NatiJoseph/ImageDisplayingSword/Results/Photos/WhatsApp Image 2021-04-10 at 18.08.34 (1).jpeg

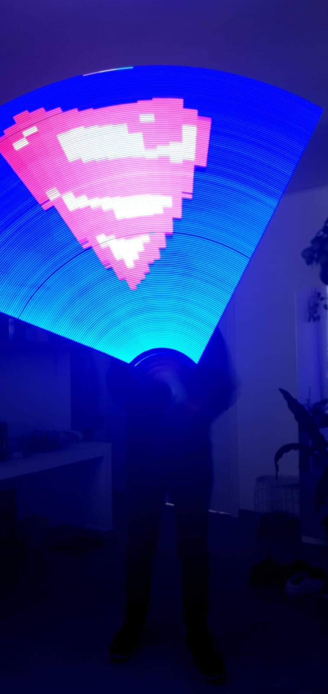
Results/Photos/WhatsApp Image 2021-04-10 at 18.08.34 (1).jpeg
