NatiJoseph/ImageDisplayingSword/CRML_Poster_ImageDisplaying_proj.pptx

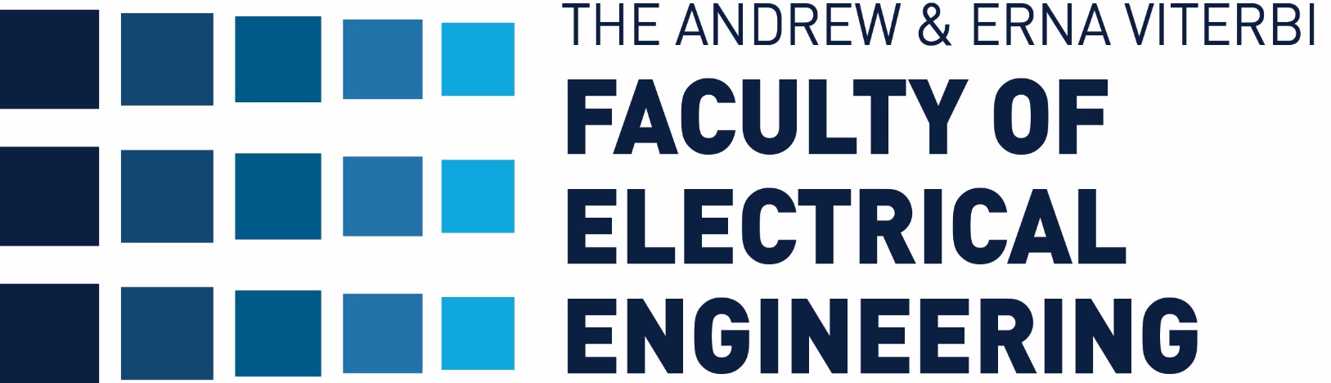
[picture p3: figure]
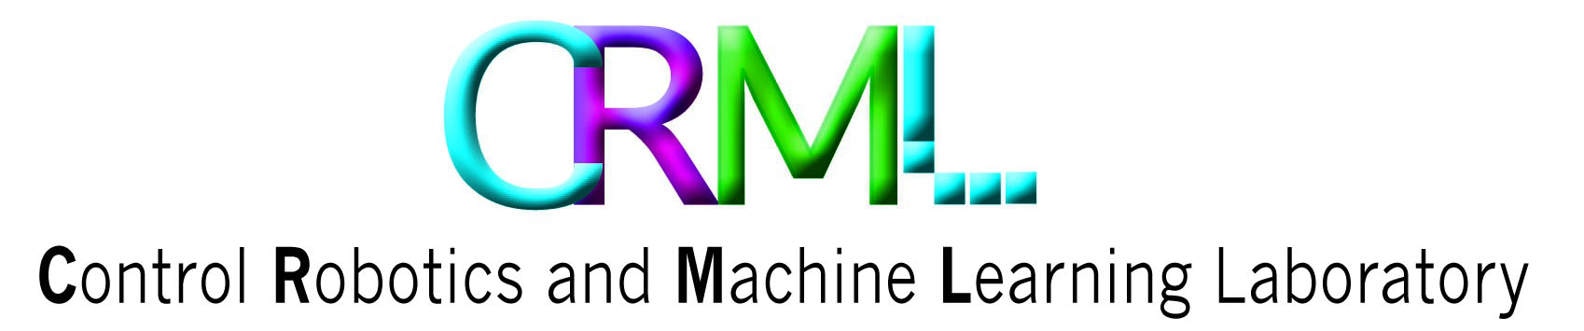
[picture p4: figure]
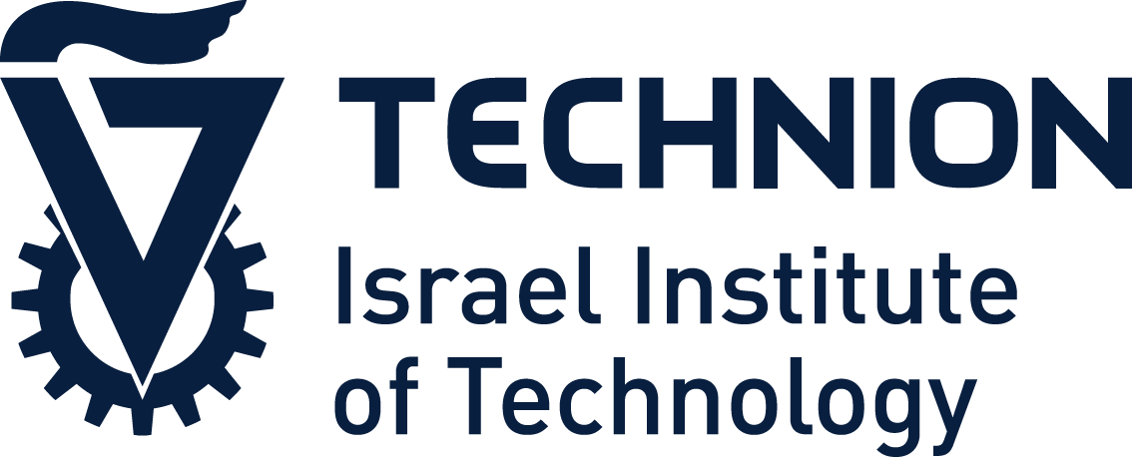
[picture p5: figure]

Image
Displaying
Sword

Nathaniel Joseph and Daniel Gutman, Supervised by Koby Kohai

Introduction

- Persistence of Vision (POV) refers to the optical illusion that occurs when visual perception of an object does not cease for some time after the rays of light proceeding from it have ceased to enter the eye.
- The entire film industry is based on POV – this is how a few pictures of a house displayed one after each other can produce a film of a running horse.

Goals

- Produce a picture from a single line of LED’s by moving it swiftly.
  - Gyroscope and Accelerometer provides input
  - Computing device angle and pixels to display.
  - Fast LED display.

Challenges

- No prior experience in IoT.
- Coronavirus pandemic.
- No suitable solutions in the literature

Software

- Fast execution and easy to operate.
- Reading values calculated by the MPU6050 gyroscope and accelerometer in order to estimate the location and angle of the device in 3-axis.
- Converting sensor output to radians using the formula rad=angle∗π/180 .
- Calculating the proper pixels to display from the picture matrix via (pixel_x , pixel_y )=(r∗cos(angle_(rad) )+ 3∗NUMPIXELS, r∗sin(angle_(rad) ))
- Displaying the corresponding RGB pixels for each LED.

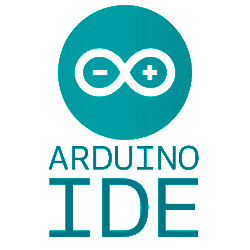
[picture p6: figure]
botsolvers.com/wp-content/uploads/2020/04/Ardui...

Hardware

- Low cost.
- Low power .
- Small footprints.
- High quality.
- Single ESP32 D1 mini controller used to control:
  - MPU6050 sensor for gyroscope and accelerometer data.
  - WS2182B LED strip in order to produce the image.
  - Audio Amplifier for sound.
- Custom design with SolidWorks of exterior shell for the device:
  - Special design for ventilation of battery and DC-DC convertor.
  - Easy connection to ESP32 controller.
  - Audio holes for better sound quality.
  - Easy assembling.

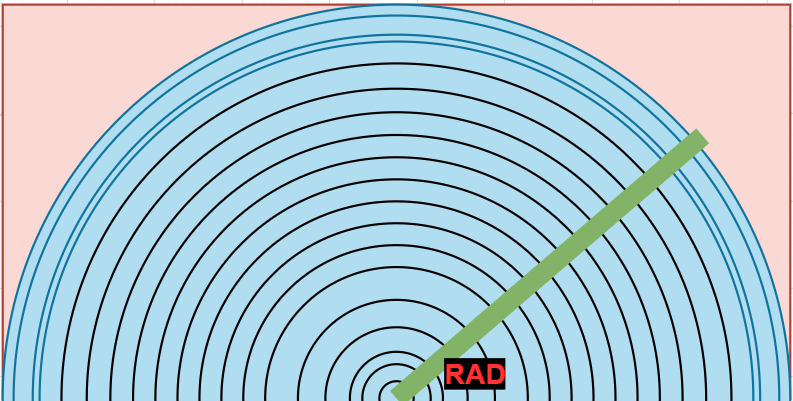
[picture p7: figure]
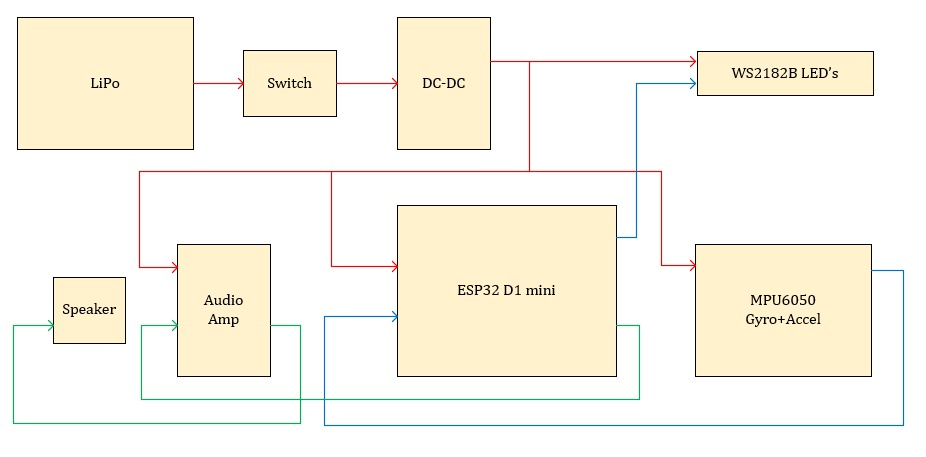
[picture p8: figure]
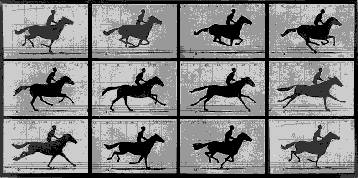
[picture p9: figure]
Persistence of Vision/POV | Stop Motion Animation
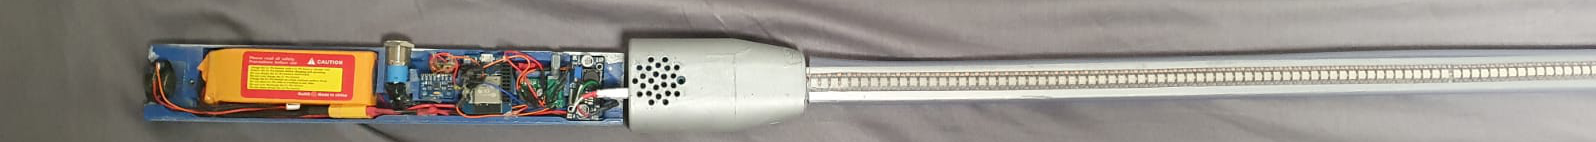
[picture p10: figure]

Results

- Implementation of a LED sword that is based on the Persistence of Vision theory.
- Light weight, easy to use product.
- Added sound for better user experience.
- Easy Image loading, without the need to disassemble the sword.
- Able to display any image.

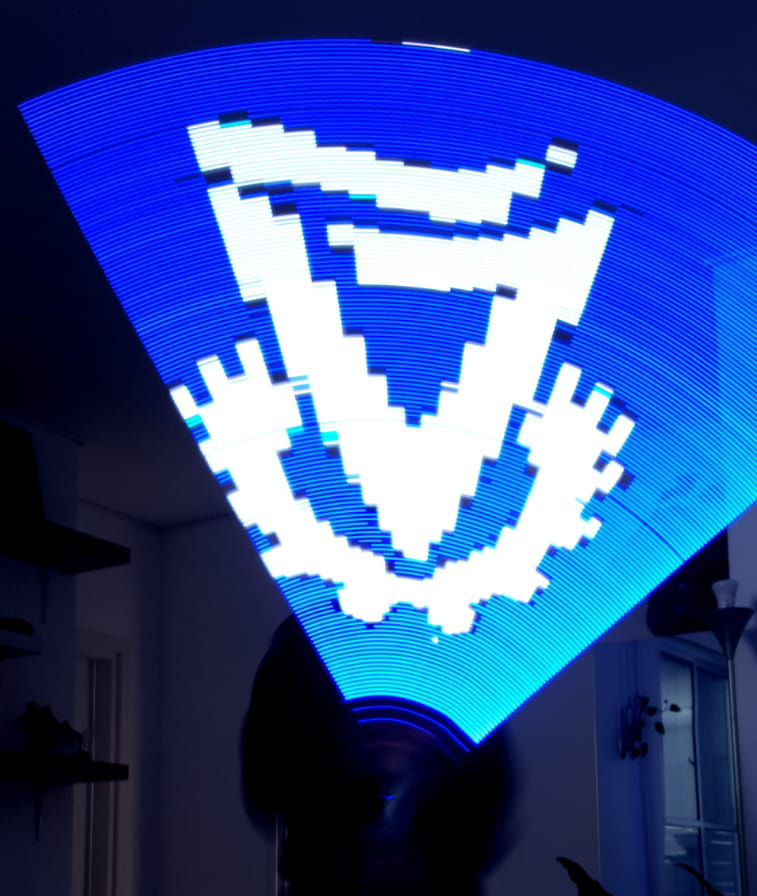
[picture p11: figure]
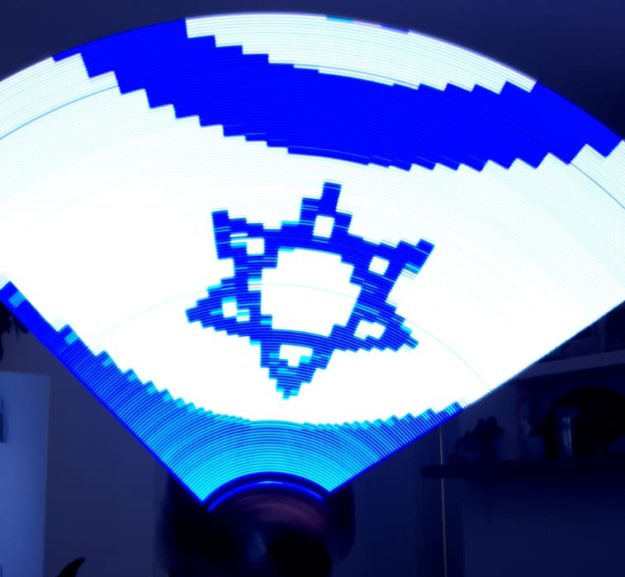
[picture p12: figure]
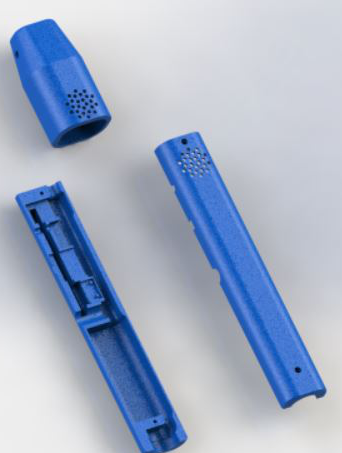
[picture p13: figure]
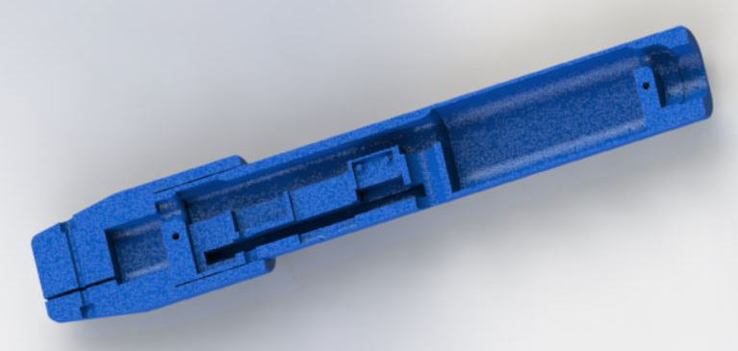
[picture p14: figure]

The Loaded Picture

- Loaded picture dimension 320*160.
- Picture will be in BMP format, 8-bit RGB.
- The displayed picture will be a semicircle produced by swinging the sword from side to side.

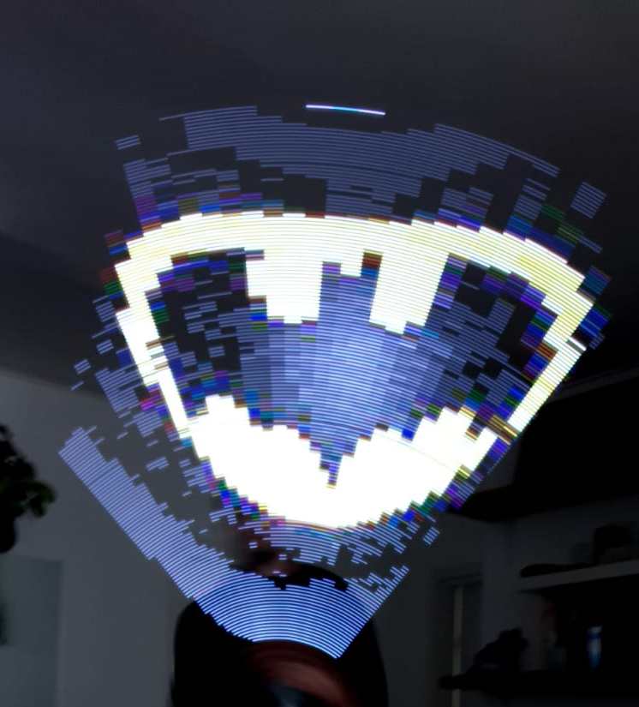
[picture p15: figure]
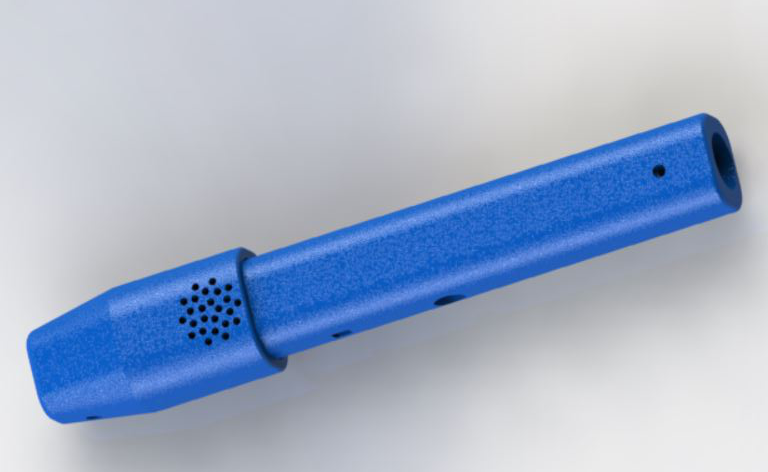
[picture p16: figure]
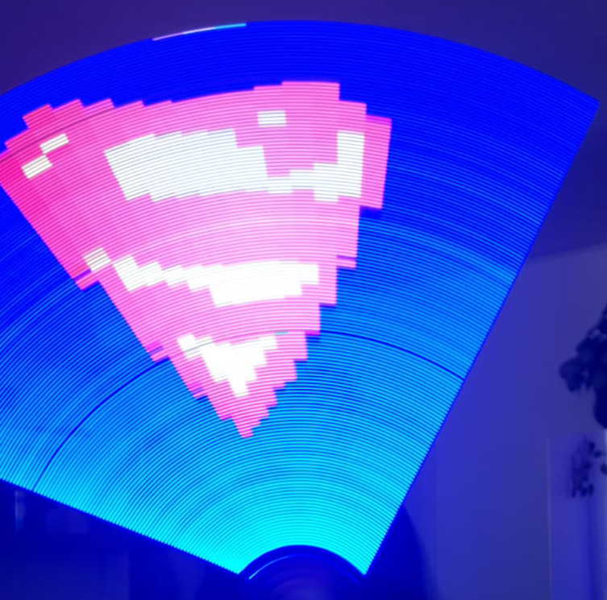
[picture p17: figure]

- Successful presentation of different complexity and quality of pictures:
  - Accurate device position detection
  - High quality display.
- Future improvement’s:
  - App for better picture customization.
  - Produce audio based on swing direction and speed.
  - Buttons that enable the user to change sounds and pictures on-demand.

Conclusions and Future Suggestions

April 2021
