NatiJoseph/ImageDisplayingSword/Project_Book.pdf

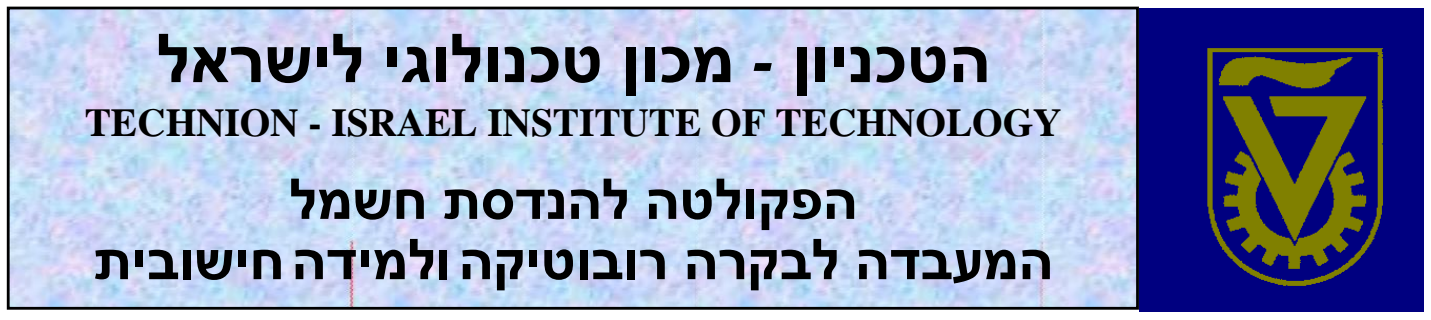
[picture p18: figure]
הטכניון - מכון טכנולוגי לישראל; הפקולטה להנדסת חשמל המעבדה לבקרה רובוטיקהולמידהחישובית

## דוח פרויקט : סטארט-אפ

# Image Displaying Sword

## דניאל גוטמן

מגישים

## נתניאל ג'וזף

מנחה

## קובי קוחי

סמסטר: אביב

שנה: 2021

TECHNION - ISRAEL INSTITUTE OF TECHNOLOGY

## תוכן עניינים

.1 מטרת הפרויקט 4 |
.2 מבוא 5 |
2.1 תיאור כללי 5 |
2.2 רקע תיאורטי 6 |
.3 תיאור7 |
.4 תיאור חומרה 8 |
4.1 סכמה 8 |
9 | ESP32 mini 4.2
11 | MPU6050 4.3
12 | DC-DC Convertor 4.4
12 | PAM8403 4.5
13 | WS2182B 4.6
13 | LIPO 11.1V 4.7
14 | HALO Switch 4.8
14 | Speaker 4.9
4.10 מעטפת ושלד 15 |
.5 תיאור תוכנה16 |
5.1 מבנה16 |
5.2 הסבר 16 |
5.3 פירוט 17 |
.6 תוצאות19 |
.7 סיכום ועבודה עתידית 20 |
.8 הוראות הפעלה 21 |
.9 רשימת מקורות 22 |

## רשימת איורים

Figure 1 - Hello World POV | 4 (https://intel-my.sharepoint.com/personal/daniel_guttman_intel_com/Documents/Desktop/פרויקט%20בארדואינו/יb.docx)
Figure 2 - Pikachu, KFV POV | 4 (https://intel-my.sharepoint.com/personal/daniel_guttman_intel_com/Documents/Desktop/פרויקט%20בארדואינו/יb.docx)
Figure 3 - Display POV | 4 (https://intel-my.sharepoint.com/personal/daniel_guttman_intel_com/Documents/Desktop/פרויקט%20בארדואינו/יb.docx)
Figure 4 - Final Sword | 7 (https://intel-my.sharepoint.com/personal/daniel_guttman_intel_com/Documents/Desktop/פרויקט%20בארדואינו/יb.docx)
Figure 5 - Block scheme | 8 (https://intel-my.sharepoint.com/personal/daniel_guttman_intel_com/Documents/Desktop/פרויקט%20בארדואינו/יb.docx)
Figure 6 - ESP32 D1 mini | 9 (https://intel-my.sharepoint.com/personal/daniel_guttman_intel_com/Documents/Desktop/פרויקט%20בארדואינו/יb.docx)
Figure 7 - ESP32 D1 mini Pin Layout | 10 (https://intel-my.sharepoint.com/personal/daniel_guttman_intel_com/Documents/Desktop/פרויקט%20בארדואינו/יb.docx)
Figure 8 - MPU6050 | 11 (https://intel-my.sharepoint.com/personal/daniel_guttman_intel_com/Documents/Desktop/פרויקט%20בארדואינו/יb.docx)
Figure 9 - MPU6050 Pin Layout | 11 (https://intel-my.sharepoint.com/personal/daniel_guttman_intel_com/Documents/Desktop/פרויקט%20בארדואינו/יb.docx)
Figure -10 DC-DC Convertor | 12 (https://intel-my.sharepoint.com/personal/daniel_guttman_intel_com/Documents/Desktop/פרויקט%20בארדואינו/יb.docx)
Figure 11 - PAM 8403 | 12 (https://intel-my.sharepoint.com/personal/daniel_guttman_intel_com/Documents/Desktop/פרויקט%20בארדואינו/יb.docx)
Figure 12 - WS2182B | 13 (https://intel-my.sharepoint.com/personal/daniel_guttman_intel_com/Documents/Desktop/פרויקט%20בארדואינו/יb.docx)
Figure 13 - LIPO Battery | 13 (https://intel-my.sharepoint.com/personal/daniel_guttman_intel_com/Documents/Desktop/פרויקט%20בארדואינו/יb.docx)
Figure 14 - HALO Switch | 14 (https://intel-my.sharepoint.com/personal/daniel_guttman_intel_com/Documents/Desktop/פרויקט%20בארדואינו/יb.docx)
Figure 15 - HALO Switch Connection | 14 (https://intel-my.sharepoint.com/personal/daniel_guttman_intel_com/Documents/Desktop/פרויקט%20בארדואינו/יb.docx)
Figure 16 - Speaker | 14 (https://intel-my.sharepoint.com/personal/daniel_guttman_intel_com/Documents/Desktop/פרויקט%20בארדואינו/יb.docx)
Figure 17 - Metal Frame | 15 (https://intel-my.sharepoint.com/personal/daniel_guttman_intel_com/Documents/Desktop/פרויקט%20בארדואינו/יb.docx)
Figure 18 - Disassembled Skeleton | 15 (https://intel-my.sharepoint.com/personal/daniel_guttman_intel_com/Documents/Desktop/פרויקט%20בארדואינו/יb.docx)
Figure 19 - Assembled Skeleton | 15 (https://intel-my.sharepoint.com/personal/daniel_guttman_intel_com/Documents/Desktop/פרויקט%20בארדואינו/יb.docx)
Figure 20 - Disassembled Skeleton Up | 15 (https://intel-my.sharepoint.com/personal/daniel_guttman_intel_com/Documents/Desktop/פרויקט%20בארדואינו/יb.docx)
Figure 21 - Pixel Calculation | 17

## .1 מטרת הפרויקט

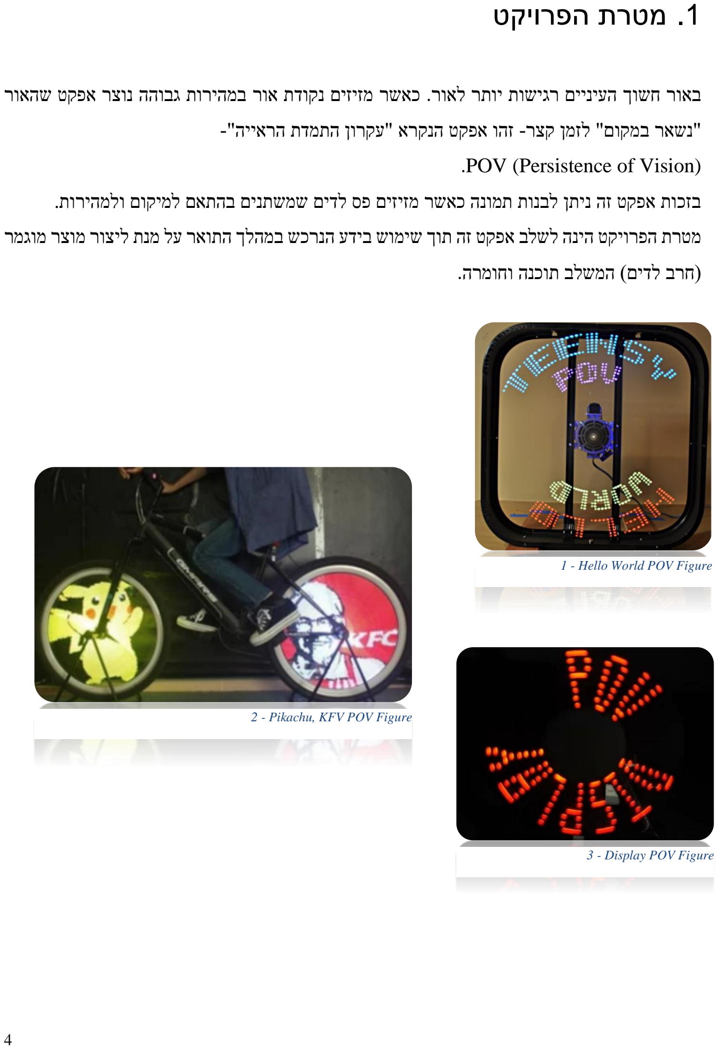
[picture p19: page 4]

1 - Hello World POV Figure

2 - Pikachu, KFV POV Figure

3 - Display POV Figure

באור חשוך העיניים רגישות יותר לאור. כאשר מזיזים נקודת אור במהירות גבוהה נוצר אפקט שהאור

"נשאר במקום" לזמן קצר - זהו אפקט הנקרא "עקרון התמדת הראייה"-

.POV (Persistence of Vision)

בזכות אפקט זה ניתן לבנות תמונה כאשר מזיזים פס לדים שמשתנים בהתאם למיקום ולמהירות.

מטרת הפרויקט הינה לשלב אפקט זה תוך שימוש בידע הנרכש במה לך התואר על מנת ליצור מוצר מוגמר

)חרב לדים( המשלב תוכנה וחומרה.

## .2 מבוא

במהלך לימודינו בטכניון בחרנו במסלול הנדסת מחשבים בו לומדים שילוב של לימודי הנדסת חשמל

ולימודי מדעי המחשב. רכשנו ידע במגוון קורסי חומרה ותוכנה, אך הידע לרוב נשאר בגדר תיאוריה

ולרוב לא זכינו להתעסק במימוש מעשי של הידע שרכשנו ובייחוד לא יצא לנו להתעסק בחומרה.

בפרויקט הנ"ל אנו משתמשים בידע הנרכש בקורסים ומממשים מוצר מעשי המשלב בתוכו חומרה

ותוכנה.

הפרויקט הנ"ל איפשר לנו להתעסק במעגל חשמלי הכולל בקר, נגדים, מקורות מתח חוטים ועוד ובד

בבד להתעסק בכתיבת קוד לרכיבי החומרה בהם השתמשנו כך שהקוד מבצע אינטגרציה לכל החלקים

על ידי טעינתו לבקר המערכת.

בדו"ח זה נפרט על כל שלבי הבנייה של הפרויקט, על הרכיבים השונים המרכיבים את המעגל, על הקוד

הנטען לבקר המעגל על החומרים בהם השתמשנו לבניית המוצר וכן על אופן טעינת תמונה חדשה לחרב

והפעלתה.

### 2.1 תיאור כללי

העין האנושית ממשיכה ”לראות“ אור זמן קצר אחרי שהוא נעלם בפועל - זהו עיקרון שנקרא עיקרון

התמדת הראייה- (Vision Of Persistence(=POV. כל אמנות הקולנוע והצילום של תנועה מבוסס

עליו.

עיקרון התמדת הראייה, הנקרא גם עיקרון התמדת המראה, אומר בעצם שאם מוקרנת שורה של

תמונות בודדות במהירות ובין אחת לשנייה מוקרן חושך, נוצרת אשליה של תנועה רציפה.

הבסיס של עקרון התמדת הראייה נובע מהפירוש שהמוח נותן לסדרת תמונות קפואות שמוצגות בזו

אחר זו במהירות. המוח תופס את סדרת התמונות הזו כאילו היו תמונה אחת, תמונה של תנועה. כיום

התפיסה היא שזה קורה במוח, אבל פעם סברו שהסיבה לכך היא שהתמונה הקודמת נשארת ומתמידה

)מכאן "התמדת הראייה"( לחלקיק שנייה על גבי רשתית העין - אותו חלק שאחראי על המרת האור

לאותות העצביים שמשודרים למוח.

כך יכול רצף של תמונות בודדות ובהן סוס רץ להפוך לתמונה נעה, כשהן מוקרנות בר צף.

גם בקולנוע המצולם וגם בסרטי אנימציה משתמשים בעיקרון התמדת הראייה כדי ליצור אשליה של

תנועה.

בפרויקט זה שולב עיקרון זה עם הרקע הלימודי שלמדנו על ידי כך שמוקרנת שורת פיקסלים המשתנה

בהתאם לזוית החזקת ידית החרב. היות ובין הצגת כל שורת פיקסלים מוקרן חושך )בסביבה חשוכה( על

פי עיקרון זה העין האנושית מצליחה לחבר את כל שורות הפיקסלים לכדי תמונה ובעצם אנו בפרויקט

זה מצליחים להעביר לצופה תמונה דו מימדית על ידי חרב לדים.

### 2.2 רקע תיאורטי

בפרויקט זה אנו משתמשים בידע התיאורטי שרכשנו בקורס מעגלים חשמלים – אנו בונים מעגל חשמלי

המשלב בתוכו רכיבים חשמלים שונים, כגון: בקר, מתג, ממיר מתח, נורות ועוד. בנוסף, תוכנת המוצר

ממומשת בשפה C אשר נלמדה בקורס מבוא למדעי המחשב.

התיאוריה עליה מבוססת המוצר ) POV )נלמדה בקורס מערכות ראיה ושמיעה.

כלל היכולות והידע הללו שנרכשו הביאו אותנו לכדי הבנה כי ביכולתנו לממש חרב לדים שבעת הנפת

החרב מצד אחד לאחר ניתן להעביר לצופה תמונה צבעונית דו מימדית )הצבעים נקבעים בהתאם

לפיקסלים המתאימים לתמונה בפורמט RGB).

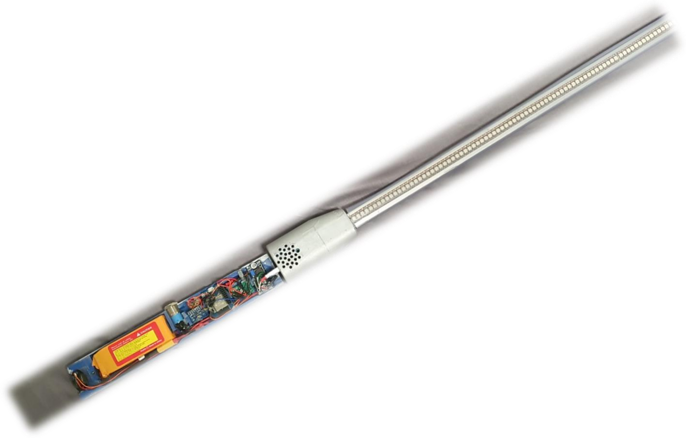
[picture p20: figure]

4 - Final Sword Figure

## .3 תיאור

כפי שכבר צ וין, בפרוייקט זה מומש עיקרון התמדת הראייה דרך חרב קלה )פחות מ- 1 ק"ג( כך שבתוך

ידית החרב )ניצב החרב( מצוי המעגל החשמלי הכולל את הבקר )אליו נטען הקוד והוא המספק את המידע

לשאר הרכיבים(, מקורות מתח )בטריה(, רמקול, ממיר מתח, ג'ירוסקופ ועוד, ובלהב החרב מצוי פס

הלדים אשר בתזוזה מחליף את צבעי הלדים בהתאם לתמונה הנקראת.

גודל פס הלדים הוא 160 לדים ולכן התמונה תהיה באורך 160 פיקסלים וברוחב 320 פיקסלים.

בהתאם לזוית בה ניצב החרב מוחזק תיקבע איזה שורת פיקסלים יש להציג דרך הלדים כך שבכל תזוזה

ותזוזה הלדים ישתנו.

אופן טעינת תמונה חדשה לחרב יפורט בהמשך.

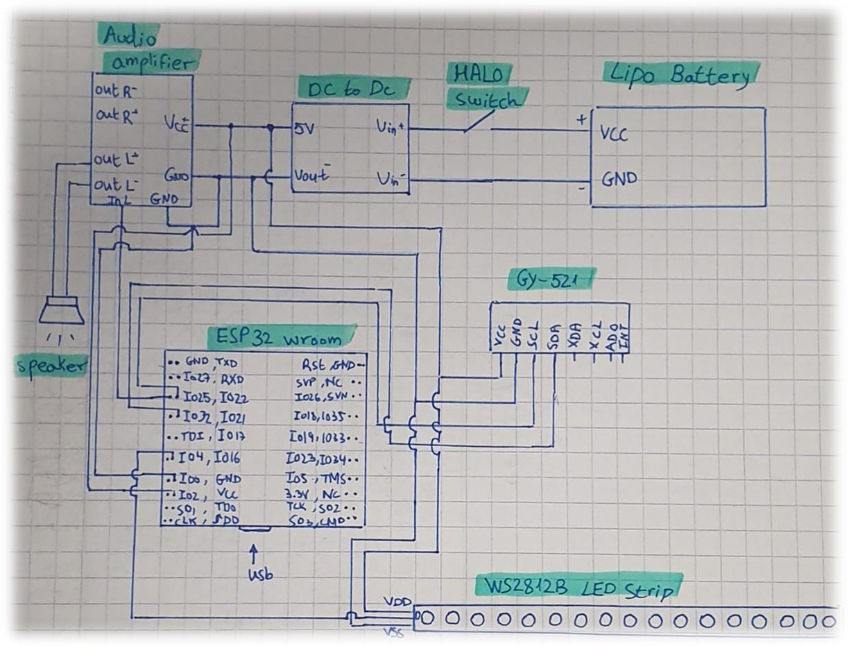
[picture p21: figure]

5 - Block scheme Figure

## .4 תיאור חומרה

### 4.1 סכמה –

בתרשים זה ניתן לראות את כלל יחידות החומרה המרכיבות את המעגל החשמלי המצוי בניצב ובחנית

החרב.

מקור המתח במעגל הינו הבטריה אשר מזרימה זרם חשמלי אל רכיב ה- Dc2Dc( ממיר מתח( כאשר

המתג סגור. ממיר המתח מוריד את המתח החשמלי מV11.1 אל V5 כיוון ששאר הרכיבים החשמלים

במעגל עובדים במתח זה.

מתח העבודה ) V5 )מסופק הן לבקר המערכת ) 32ESP )הן ל-Amplifier Audio האחראי על יצירת

השמע )דרך רמקול שמחובר למוצאו(, הן לג'ירוסקופ והן לפס הלדים.

הבקר, אליו נטען הקוד )שיפורט בהמשך( אחראי לקרוא את ערכי הג'ירוסקופ ובהתאם אליהם להעביר

את המידע המתאים אודות הצבעים שיוצגו בכל פיקסל בפס הלדים.

כמו כן, הבקר אחראי לספק את המידע המתאים ל- Amplifier Audio לצורך יצירת השמע.

ESP32 mini 4.2

Mini 1D 32ESP משמש לסביבת פיתוח של SoC. הוא מציע פתרון זול ליצירת מוצרים אשר מחוברים

לאינטרנט ול-BLUETOOTH. למרות שה- 32ESP מבוסס על ה- 8266ESP, המבנה של ה- 32ESP

Mini 1D מאפשר לו להשתמש ברוב הפונקציונליות של ה- 32ESP. בנוסף, גודלו הקטן ומגוון הכלים

הרחב שבו הופך אותו לפתרון אידאלי ליצירת אב טיפוס לפרויקט IoT המוגבל במקום.

ה-Mini 1D 32ESP מציע מגוון פיצ'רים:

- אנטנת PCB.
.Micro-USB | חיבור | •

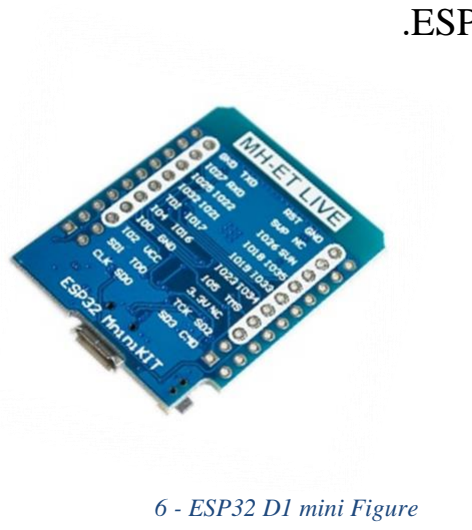
[picture p22: figure]
6 - ESP32 D1 mini Figure

.ESP32 FCC certified Wi-Fi and BLUETOOTE •

.USB-to-serial •

:GPIO •

3*UART •

2*I2S •

3*SPI •

18*ACD input channels •

2*DAC output channels •

2*I2C •

.פין בכל PWM/timer input/output •

OpenOCD debug interface •

SDIO master/slave (50 MHz) •

External SPI flash (16MB) •

39mm*31mm : | גודל | •

500mA •

3.0-5.5V DC •

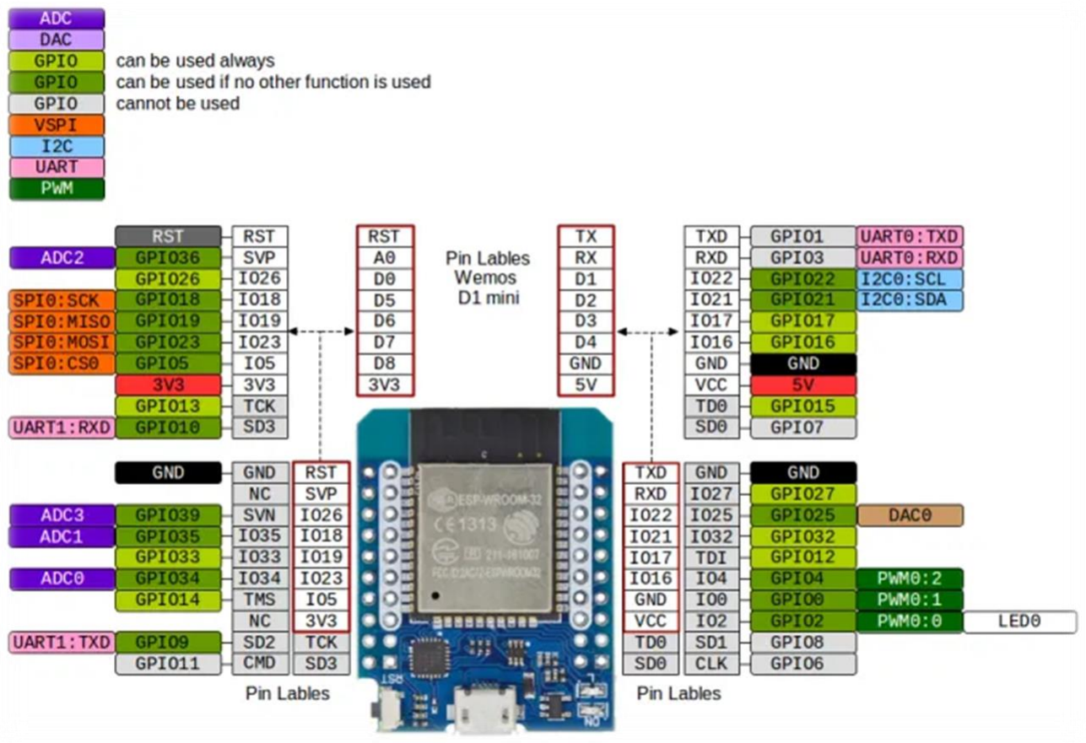
[picture p23: figure]

7 - ESP32 D1 mini Pin Layout Figure

הבקר Mini 1D 32ESP מכיל את קטע הקוד אשר מריץ את המערכת ואת קבצי השמע והתמונות

המשמשים אותו להשמעת השמע והצגת התמונה. כאשר הבקר מופעל על ידי קבלת המתח המתאים, הוא

מתחיל את פעולת הג׳ירוסקופ ולאחר מכן קורא את המידע הנמצא בו. הבקר מאפס את המערכת ומשמיע

קול כאשר הוא מוכן לשימוש. לפי המידע שמתקבל מהג׳ירוסקופ, הבקר מחשב את הזווית אשר בה הוא

נמצא ושולח את צבעי הפיקסלים המתאימים לפס הלדים, שבתורו נדלק ומציג את התמונה.

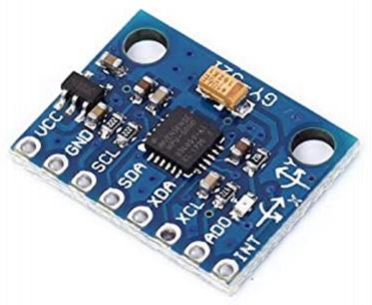
[picture p24: figure]

8 - MPU6050 Figure

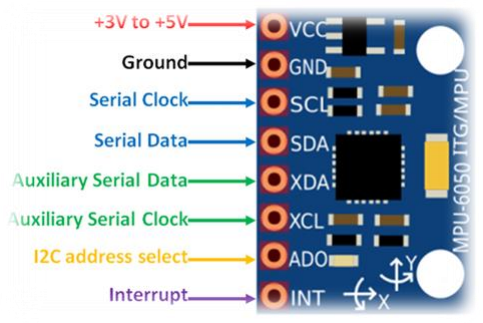
[picture p25: figure]

9 - MPU6050 Pin Layout Figure

MPU6050 4.3

ה6050-MPU הינו חיישן הדורש מתח נמוך, המשלב ברכיב בודד גם ג׳ירוסקופ 3 צירים וגם מד תאוצה

3 צירים.

הג׳ירוסקופ מודד מהירות זוויתית או את קצב שינוי הזווית לאורך זמן בשלושת הצירים Y ,X ו-Z. הוא

משתמש בטכנולוגית MEMS ובאפקט קוריוליס בשביל לבצע את המדידה.

פלט הג׳ירוסקופ הינו ביחידות של second per degrees ולכן בשביל לקבל את המיקום הזוויתי יש

צורך במידע אודות המהירות הזוויתית.

מד התאוצה מודד את תאוצת הכובד לאורך שלושת הצירים Y ,X ו-Z ובעזרת טריגונומטריה ניתן לחשב

את הזווית שבה החיישן ממוקם. בצורה זו, בעזרת שילוב המידע מהג׳ירוסקופ ומד התאוצה אנו מסוגלים

לחשב בצורה מדויקת את הזווית שהחיישן נמצא.

פיצ׳רים:

- ג׳ירוסקופ 3 צירים
- מד תאוצה 3 צירים
- מתח הפעלה: V3-5
- תקשורת דרך פרוטוקול C2I
- 16 ביט ADC
- DMP מובנה
- התממשקות עם רכיבי IIC( מגנומטר(
- כתובת IIC הניתנת לשינוי
- תרמוסטט מובנה

אנו משתמשים ב6050-MPU על מנת לחשב את הזווית שבה החרב נמצאת. החיישן מחובר לבקר שלנו,

אשר קורא את המידע הנמצא בחיישן ומחשב לפיו את הזווית המבוקשת.

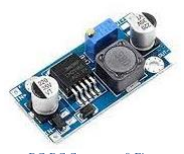
[picture p26: figure]
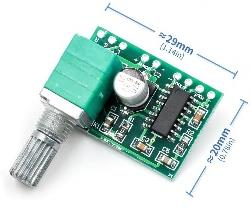
[picture p27: figure]

10 - PAM 8403 Figure

DC-DC Convertor -9 Figure

DC-DC Convertor 4.4

ממיר DC ל- DC הינו מעגל חשמלי המשמש להמרת מקור מתח ישיר מרמת מתח אחת לאחרת, רכיב

זה משמש בעיקר למוצרים אשר משתמשים במקור מתח מסוג סוללה. השימוש העיקרי לממירי מתח

הינם במעגלים מורכבים הבנויים מכמה תתי- מעגלים הדורשים מתחים שונים, תפקיד ממירי המתח במעגל

זה יהיה להמיר את המתח המקבל מהסוללה למתח הדרוש על ידי כל תת מעגל אשר ממיר מתח מחובר

אליו.

אנו משתמשים בממיר מתח משום שהסוללה שהשתמשנו בה הייתה בעלת מתח גבוה יותר מדרישות

הרכיבים במעגל. ממיר המתח מחובר ישירות לסוללה ולמתג המפעיל את המעגל ומצדו השני לשאר

רכיבי המעגל אשר דורשים את אותו מתח עבודה.

PAM8403 4.5

ה8403-PAM הינו מגבר שמע המופעל באמצעות מתח של V5 ומסוגל להפעיל שני W3 רמקולים.

מגבר שמע מאפשר להגיע לאיכות שמע גבוהה יותר. גודלו ומתח ההפעלה הנמוכים שלו הופכים אותו

לבחירה אופטימלית עבור מוצר המוגבר במקום. בנוסף, למגבר זה יש פיצ׳ר המאפשר הפעלת רמקולים

ישירות ממוצא הרכיב.

פיצ׳רים:

- מתח הפעלה נמוך ורחב הנע בין V2.5 ל- V5.5 DC.
- שני ערוצי סטריאו עם מתח יציאה גבוה Ω4 W+3W3
- טמפרטורת פעולה בין -45 ל85- צלזיוס
- הגנה מפני קצרים
- הגנה מפני חום

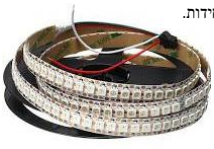
[picture p28: figure]

11 - WS2182B Figure

12 - LIPO Battery Figure

WS2182B 4.6

ה-B2182WS הינו בקר מקור אור חכם בו רכיב הבקר ורכיב ה-RGB משולבים יחד.

רכיבי ה-B2182WS משורשרים אחד לשני כך שאחרי הפעלת הרכיבים, כל רכיב קורא את 24 הביטים

הראשונים של המידע אשר הם מקבלים ומעבירים הלאה את שאר המידע לרכיב הבא אחריו.

רכיב זה הינו LED הדורש מתח נמוך, בעל מעטפת הגנתית, שומר אנרגיה, בעל זווית ראיה רחבה, בעל

מדרגיות גבוהה, זול, בעל חיי מדף ארוכים ויתרונות רבים נוספים ולכן היווה עבורנו את הבחירה הטובה

ביותר למוצר.

פיצ׳רים:

- הגנה מפני חיבור מתח הפוך.
- חיבור יחיד למתח עבור הבקר והנורה.
- הבקר ונורת ה- LED משולבים ברכיב יחיד המורכב מ5050- רכיבים שונים היוצרים בקרה

שלמה עבור כל פיקסל.

- רכיב מיוחד המובנה בבקר מאפשר שרשור קל של יחידות.
- 256 רמות בהירות
- 16777216 צבעים
- תדירות סריקה של s/Hz400
- מתח הפעלה V3.5-5.3 DC

LIPO 11.1V 4.7

סוללות ליתיום פולימר )LiPo )הינה בטרייה נטענת מטכנולוגית ליתיום-יון המשתמשת באלקטרוליט

פולימרי במקום באלקטרוליט נוזלי. מתח סוללות אלו הינו בערך פי 3 מסוללות נטענות אחרות.

סוללות אלו נפוצות באפליקציות של מכשירים אלקטרונים ניידים הודות לצפיפות האנרגיה הגבוהה

שלהן, מספר מחזורי פריקה/טעינה גבוה ואיבוד נמוך של הקיבול במהלך המחזורים ולכן בחרנו להשתמש

בו במוצר. בנוסף זהו הסוללה שסופקה לנו.

מכיוון שהמתח אותו מספקת הסוללה גבוה מהמתח של המוצר, השתמש נו בממיר המתח בשביל להעביר

את המתח מ- V11.1 ל- V5 שזהו מתח העבודה של המוצר.

13 - HALO Figure
Switch

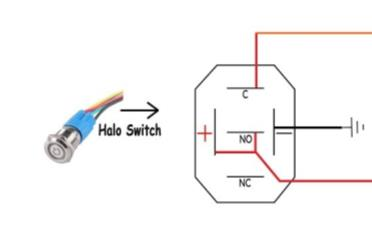
[picture p29: figure]

14 - HALO Switch Figure
Connection

15 - Figure
Speaker

HALO Switch 4.8

זהו כפתור ההדלקה והכיבוי של המוצר ובעצם הכפתור שמאתחל את ריצת הקוד וקריאת

ערכי הג'ירוסקופ. בעת לחיצת על כפתור זה המערכת מתחילה לרוץ על ידי הפעלת

קטע שמע והדלקת פס הלדים בהתאם לזוית הג'ירוסקופ.

כדי לא לבזבז אנרגיה כאשר החרב לא בשימוש, תוכנן הכפתור כך שכאשר לוחצים

עליו נדלק אור חיווי אדום והזרם החשמלי מגיע לשאר רכיבי המעגל.

כדי לממש זאת חובר ה"-" אל האדמה )המוצא השלילי של הבטריה(,

ה-"C "אל המוצא החיובי של הבטריה והפינים "+" ו-" NO "אל הכניסה

החיובית של ממיר המתח.

Speaker 4.9

רמקול עבודה בסיסי ברכיבים חשמליים. מחובר ישירות אל ה- Amplifier Audio ומספק את השמע

למוצר. מחובר בתחתית ידית החרב כיוון שזהו רכיב רגיש ובכך אנו חוסכים פגיעות ברכיב.

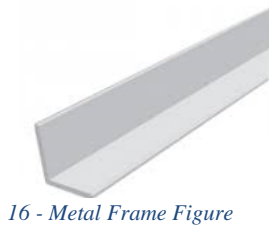
[picture p30: figure]
16 - Metal Frame Figure
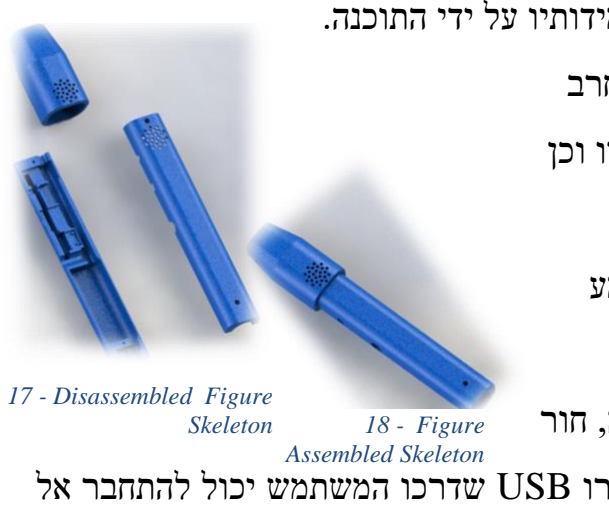
[picture p31: figure]
17 - Disassembled Figure; Skeleton; 18 - Figure; Assembled Skeleton
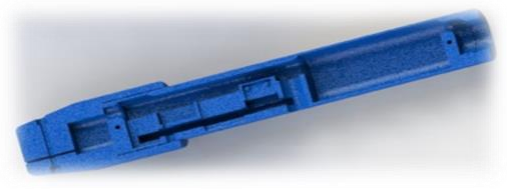
[picture p32: figure]

19 - Disassembled Skeleton Up Figure

### 4.10 מעטפת ושלד

המעטפת הודפסה במדפסת תלת מימד ביתית בעזרת תוכנת SolidWorks.

החומר בו השתמשנו הינו פלסטיק ABS אשר זהו החומר הבסיסי בהדפסה

תלת מימדית, חומר קשיח, נוח למגע, עמיד לחום וקל לנשיאה.

לכל רכיב במעגל החשמלי מקום ייעודי שהותאם בדיוק למידותיו על ידי התוכנה.

דיוק גודל הגומחות לכל רכיב ורכיב חשוב במיוחד שכן החרב

מונפת מצד לצד ויש צורך לקבע את הרכיבים כך שלא יזוזו וכן

שלא יפגעו בתפקוד נכון של הג'ירוסקופ.

בתחתית המעטפת יש חור בגודל הרמקול כך שאיכות השמע

לא תיפגע.

בצידי המעטפת ניתן למצוא חור המותאם לכפתור ההדלקה, חור

להגברה והנמכה של עוצמת השמע וכן חור המותאם למיקרו USB שדרכו המשתמש יכול להתחבר אל

בקר המערכת ולעלות תמונה חדשה בכל עת.

בחלק העליון של הידית )המעטפת( חוררו פתחי איוורור לצורך קירור רכיב הממיר מתח אשר מתחמם

במהלך פעולתו התקינה. רכיב זה מוקם בחלקו העליון של הידית על מנת לא להפריע למניף להניף את

החרב.

2 חלקי המעטפת נסגרים על ידי הברגת 2 ברגים, כך שניתן בקלות לפתוח ולסגור את המעטפת ולהקל

על פעולת הטעינה של הבטריה.

פס הלדים הודבק על פס אלומיניום קל משקל בצורת "ר" על מנת להבטיח שבעת ההנפה הפס לא יישבר.

המוצר כולו )המעטפת, פס המתכת וכלל המעגל החשמלי( שוקל כ- 900 גרם.

## .5 תיאור תוכנה

### 5.1 מבנה

הקוד נכתב בתוכנת IDE Arduino המשמשת לפיתוח תוכנות למיקרו -בקרים. התוכנה רצה בשני

שלבים:

- setup: שלב זה הינו שלב איתחול המערכת. שלב האיתחול קורה פעם אחת בתחילת הריצה.
- loop: שלב זה הינו שלב הריצה הכללי של המערכת. שלב זה הינו לולאה אינסופית המתרחשת

מיד לאחר שלב האיתחול.

בנוסף, אנו משתמשים בשני קבצי header:

- בקובץ בשם Photo המכיל מערך בשם Photo המייצג את התמונה. המערך הינו בגודל

3*320*,160 כאשר 160 הינו גובה התמונה ) מספר הלדים בפס הלדים שבחרב(, 320 הינו

הרוחב ) 2 * מספר הלדים בפס הלדים שבחרב(, ו3- עבור צבעי RGB.

- קובץ בשם SoundData המכיל מערך בשם Force המייצג את השמע המתרחש לאחר איתחול

המערכת.

### 5.2 הסבר

כאשר המערכת מופעלת, אנו מתחילים לבצע את שלב איתחול המערכת. שלב האיתחול מכיל בתוכו את

הפעלת החיישן 6050MPU ובדיקה כי הוא אכן עובד. במידה והחיישן אכן עובד נשמיע קול המורה כי

המערכת הופעלה כראוי. בנוסף, אנו מבצעים את כיול המערכת בשביל למנוע מהסטייה הטבעית של

הרכיבים להשתלט על המוצר ולפגוע באיכותו.

בסיום שלב האיתחול נתחיל בביצוע לולאת הריצה:

- קריאת ערכי החיישן ותיקונם.
- חישוב לקבלת הזווית ברדיאנים.
- חישוב ערכי הצבעים המתאימים עבור כל LED.
- הדלקת פס הלדים כנדרש.

### 5.3 פירוט

השליטה ב6050-MPU מתבצעת באמצעות המודל של light_6050MPU

)light_6050MPU/rfetick/com.github://https )המספק (https://github.com/rfetick/MPU6050_light) ממשק נוח לקריאת ערכי הג'ירוסקופ,

ערכי מד התאוצה וערכי השגיאה של החיישן. ממשק זה מספק ערכים אמינים בצורה מהירה ומתאים

לכל צרכי המערכת. בתחילת האיתחול אנו משתמשים בממשק על מנת להעיר את החיישן ולמדוד את

ערכי השגיאה. ערכים אלו משמשים אותנו לתיקון הסטייה הטבעית של הרכיב – drifting. סטייה זו

גורמת לערכי החיישנים לנדוד לכיוון מסויים עד למצב שאם לא יטופל כראוי יגרום לערכי החיישן להיות

לא אמינים. לאחר גילוי קצב הסטייה אנו מתקנים אותה על ידי הוספת קצב הסטייה הנמדד בסימן שלילי

לערכי החיישנים.
| בשביל לחשב את הזווית ברדיאנים אנו משתמשים בנוסחא ∗ lgna = ar
180

כאשר הזווית angle

המתקבלת מהחיישן מגיעה בטווח של [-90,90]. לאחר קבלת הזווית שבה החיישן נמצא ניתן לחשב את

הפיקסלים שכל נורת LED צריכה להדליק. עבור כל LED אנחנו מוצאים את מיקום הפיקסל המתאים (y ,x (בתמונה על ידי הנוסחאות: 3 ∗ LEXIPMUN + (ar)cos x = r ∗ ו- ∗ =

(ar) sin, כאשר NUMPIXELS הינו מספר הלדים בפס הלדים שבחרב ו-r נע בין 1 ל-

.NUMPIXELS

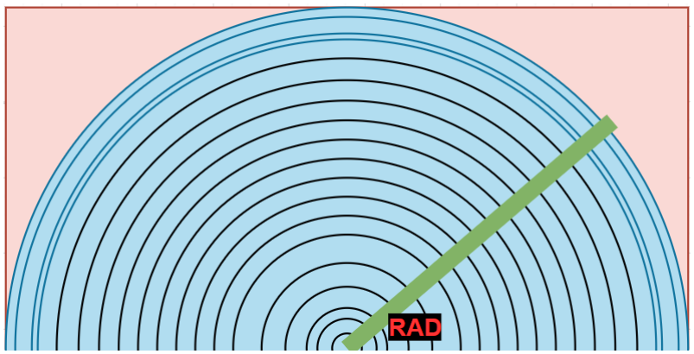
[picture p33: figure]

20 - Pixel Calculation Figure

בתמונה לעיל ניתן לראות כיצד החישוב מתבצע כאשר הפס הירוק מתאר את פס הלדים והמעגלים

ברדיוסים השונים )חצי מעגלים( מייצגים את r. ניתן לראות כי אנו נתעלם מהחלק האדום בתמונה ובעצם

נציג מעתה רק את החלק הכחול מתוך התמונה.

השליטה בפס הלדים מתבצעת באמצעות הספריה neopixel_adafruit

)NeoPixel_Adafruit/adafruit/com.github://https). ספריה זו מממשת ממשק נוח לשליטה על

פסי לדים ומספקת פונקציות פשוטות לשליטה על כל LED בנפרד, שליטה על בהירות, קביעת צבע,

כיבוי והדלקה. לאחר קבלת הפיקסלים המתאימים לכל נורת LED, נשלח את צבעי ה-RGB לפיקסל

המתאים לו. אחרי שסיימנו לקנפג את כל הפיקסלים בפס הלדים נשנה את כולם לצבעם החדש באותו

רגע בפקודת הדלקה פשוטה לכלל הלדים.

## .6 תוצאות

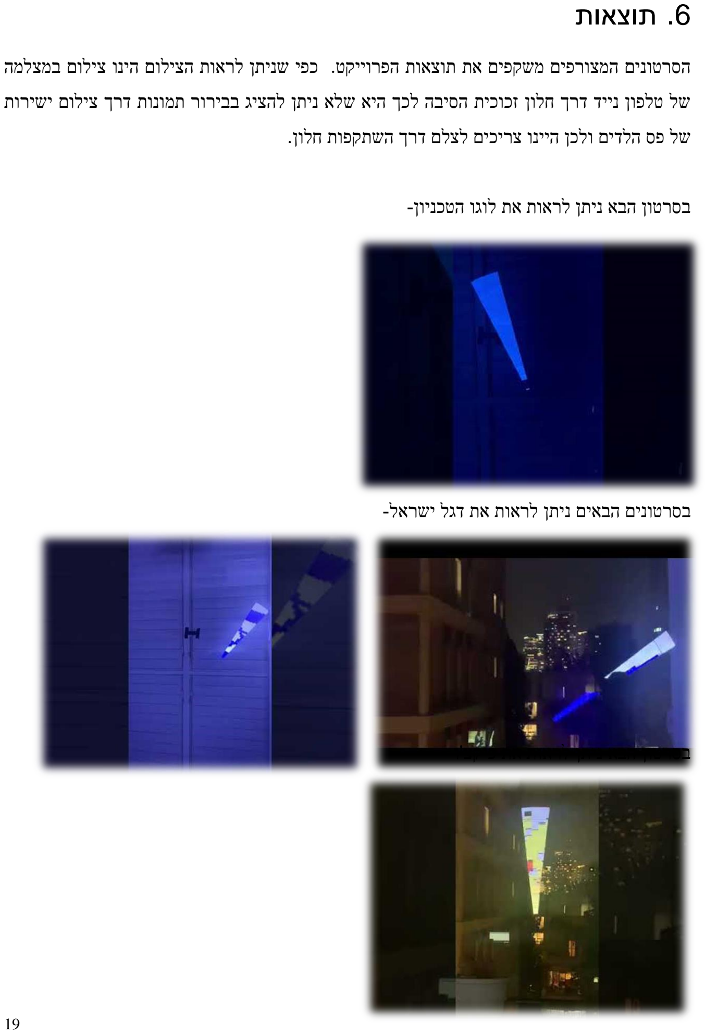
[picture p34: page 19]

הסרטונים המצורפים משקפים את תוצאות הפרוייקט. כפי שניתן לראות הצילום הינו צילום במצלמה

של טלפון נייד דרך חלון זכוכית הסיבה לכך היא שלא ניתן להציג בבירור תמונות דרך צילום ישירות

של פס הלדים ולכן היינו צריכים לצלם דרך השתקפות חלון.

בסרטון הבא ניתן לראות את לוגו הטכניון -

בסרטונים הבאים ניתן לראות את דגל ישראל-

בסרטון הבא ניתן לראות את פיקצ'ו- (https://www.youtube.com/embed/MBD9PL3RvQg?feature=oembed)

בסרטונים הבאים ניתן לראות את הסמלים של באטמן וסופרמן-

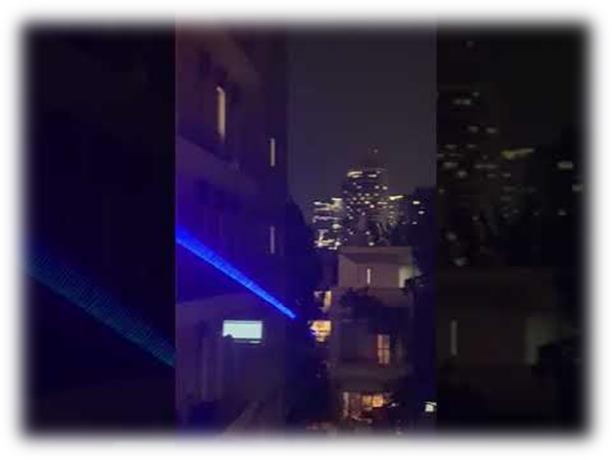
[picture p35: figure]
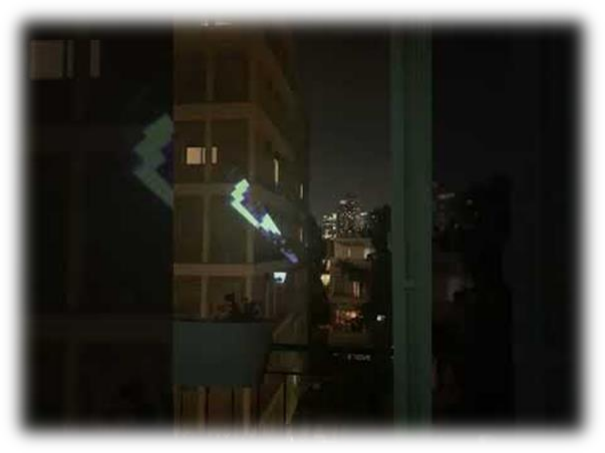
[picture p36: figure]

כמובן שכפי שמתואר בהוראות ההפעלה בהמשך כל תמונה ניתנת להצגה והסרטונים הללו הינם רק מדגם.

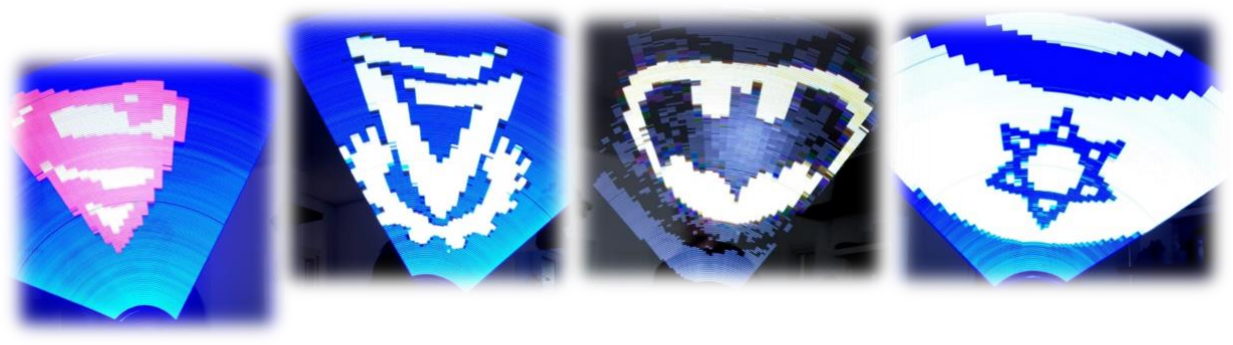
[picture p37: figure]

## .7 סיכום ועבודה עתידית

לסיכום, בפרויקט זה מימשנו חרב לדים המסוגלת להציג כל תמונה שנבחר על ידי טעינה פשוטה של

התמונה לחרב והנפתה מצד לצד. המימוש כלל בניית מעגל חשמלי מורכב עם רכיבים זעירים ורגישים

)כמצוין לעיל( ו כן כתיבת קוד היודע לקבל תמונה בה כל פיקסל מיוצג על ידי קומבינצית ערכי RGB

מתאימים.

רעיונות לשיפור להמשך-

.1 אפליקציה ידידותית למשתמש בה ניתן דרך המכש יר הסלולרי לצלם תמונה או לבחור תמונה

קיימת מגלריית התמונות של הטלפון ולטעון דרך רשת ה- WIFI ישירות לחרב.

.2 הוספת רמקול לחוויה קולית טובה יותר ועוצמה חזקה יותר.

.3 הוספת רעשי רקע וצליל הנפה כאשר מזיזים את החרב מצד לצד.

.4 הוספת כפתורים להחלפת תמונות תוך כדי שהחרב מופעלת.

.5 אופציה להחלפת רקע התמונה הנבחרת בהתאם להחלטת המשתמש.

.6 אופציה לקיפול החרב ופירוק לצורך ניידותה.

## .8 הוראות הפעלה

ראשית יש לודא כי במחשבך מותקנת תוכנת IDE Arduino, במידה ולא, ניתן להוריד את התוכנה

בקישור הבא. (https://www.arduino.cc/en/software)

כמו כן, עליך להוריד את תוכנת ההמרה converter image lcd למחשבך. התוכנה ניתנת להורדה

בקישור הבא. (https://sourceforge.net/projects/lcd-image-converter/)

כעת עקוב אחר ההוראות הבאות:

.1 פתח את הקוד של הפרויקט בעזרת התוכנה IDE Arduino. הקוד מצורף כנספח.

.2 בחר תמונה אותה תרצה להציג דרך החרב- על התמונה להיות בגודל 320x160 פיקסלים, על

מנת לדאוג שהתמונה אכן בגודל זה פתח את התמונה בתוכנת הצייר המותקנת על המחשב לחץ

בסרגל הכלים על resize ושנה את הגודל של התמונה בהתאם. שמור את התמונה )המותאמת

בגודלה( על המחשב.

.3 פתח את התמ ונה ששמרת דרך תוכנת ה-converter image lcd . בדיקת שפיות, ודא כי הגודל

של התמונה אכן 320x160על ידי לחיצה בסרגל כלים על image ולאחר מכן על resize.

.4 כעת, דרך סרגל הכלים לחץ על options ולאחר מכן על ...Conversion.

.5 בחלון הנפתח סמן בתיבת ה-Type את השדה color ובתיבת ה-direction scan main את

.Bottom to Top השדה

.6 לאחר לחיצה על ה כפתור preview show המופיע בצד שמאל למטה יפתח חלון עם מטריצת

ערכי RGB מתאימים לתמונה ) bit8). העתק את המטריצה.

.7 בקוד גש אל מטריצת התמונה שנמצאת בקובץ h.Photo ושנה את ערכי המטריצה לערכי

המטריצה שהעתקת.

.8 חבר את החרב בעזרת כבל mini USB-USB למחשב בחר את הport המתאים ואת הלוח

המתאים דרך Tools שבסרגל הכלים.

.9 לחץ על upload( חץ מכוון לצד ימין( וחכה עד שהקוד יסיים להיטען לחרב. נתק את החרב

מהכבל.

.10החזק את החרב בצורה אנכית בסביבה חשוכה ולחץ על כפתור ההפעלה.

.11הנף את החרב מצד לצד והתרשם מהתמונה המתקבלת.

## .9 רשימת מקורות

.1 עקרון התמדת הראייה מפי אינציקופדית אאוריקה- קישור (https://eureka.org.il/item/40620/%D7%9E%D7%94%D7%95-%D7%A2%D7%99%D7%A7%D7%A8%D7%95%D7%9F-%D7%94%D7%AA%D7%9E%D7%93%D7%AA-%D7%94%D7%A8%D7%90%D7%99%D7%99%D7%94)

https://artofcircuits.com/product/wemos-d1-mini-esp32-esp-wroom-32-4mb .2

https://howtomechatronics.com/tutorials/arduino/arduino-and-mpu6050- .3

/accelerometer-and-gyroscope-tutorial (https://howtomechatronics.com/tutorials/arduino/arduino-and-mpu6050-accelerometer-and-gyroscope-tutorial/)

https://components101.com/sensors/mpu6050-module .4

https://github.com/rfetick/MPU6050_light .5

הבא | קישור (https://sourceforge.net/projects/lcd-image-converter/) | -lcd image convertor .6
