NatiJoseph/ImageDisplayingSword/Results/Photos/WhatsApp Image 2021-04-10 at 18.08.34 (3).jpeg

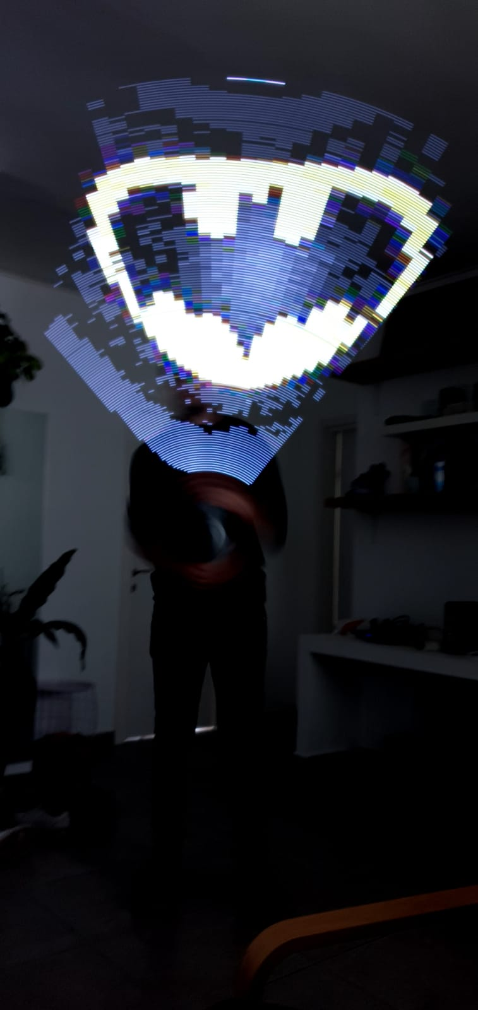
Results/Photos/WhatsApp Image 2021-04-10 at 18.08.34 (3).jpeg
